nthdimtech/signet-cad/Plots/signet-schematic.pdf

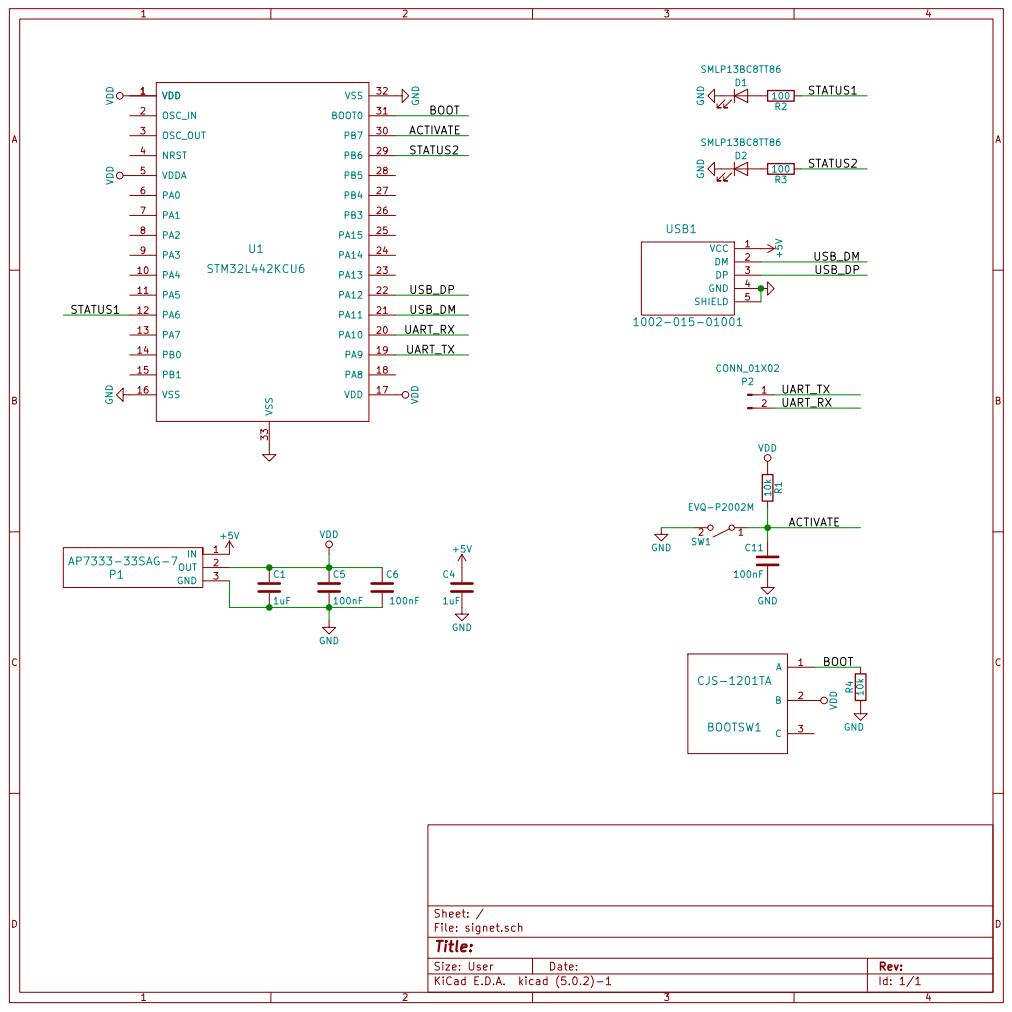
[picture p1: page 1]
