nthdimtech/signet-cad/(threads)

Thread 1 (2017-10-14):

Protection against HW attacks

dumblob, 2017-10-14:
How do you protect the content of the storage (i.e. flash memory) against HW attacks?

Mainly against reading it out e.g. by connecting to appropriate pins on the PCB and messing up with the signals (including clock/crystal). I could not find you're burning some internal transistors to protect against such attacks nor you're allowing the user to lock the flash memory (before any reading or writing can start) by a very long unique key submitted before any use. I'm not sure which locking features the chosen MCU has, but for me this is a very important question.

dumblob, 2017-10-14:
E.g. https://www.cl.cam.ac.uk/~sps32/mcu_lock.html .

nthdimtech, 2017-10-20:
Yes this is something that is on my radar. The STM32L series has memory protection features that

1) Prevent the factory boot-loader from begin activated which could allow hostile firmware to be installed
2) Prevent the SWD debugging interface from being activated which could allow flash to be read/written

See the "flash memory protection" section on page 89 of the MCU reference manual: http://www.st.com/resource/en/reference_manual/dm00151940.pdf

I'm planning on enabling this feature as soon as I support firmware update with digital signature checking. Otherwise the firmware update mechanism in the application (not the factory code) is a trivial workaround to the hardware memory protection features.

I'm using an internally generated clock so the only other kind of attack to consider is manipulation of the external voltage levels. The MCU has some protections and alarms for this kind of thing but I haven't investigated them deeply yet. I'll fine some bugs for this.

dragon788, 2017-10-20:
This probably won't affect the Signet unless it gets smartcard capabilities, but in the vein of security see also the awesome ROCA vulnerability. https://crocs-muni.github.io/roca/

Thread 2 (2017-10-20):

Firmware upload with digital signature checking

nthdimtech, 2017-10-20:
During device initialization the user should be allowed to set a "security level". For any value other than the lowest security level firmware updates will have to have a correct digital signature. In a medium security level setting the signing key would bet set at initialization but could be changed later. At a high security level the signing key would be fixed for the lifetime of the device after initialization.

nthdimtech, 2017-10-21:
This issue belongs in the firmware repository. Moving...

Closed 2017-10-21.

Thread 3 (2017-11-11):

Protection against environmental conditions

dumblob, 2017-11-11:
I wonder whether I can put Signet into a salty water, leave it there for two weeks, put it out, let it dry (at least a bit) and connect to a computer. It sounds pretty extreme, but it's a time-condensed test for e.g. United Arabic Emirates (yeah, I'm in that country more and more often and the salty humidity of 95% is really an electronics killer).

Is there any water-resistant coating on the PCB and possibly some finish of the PCB with already all components mounted?

nthdimtech, 2017-11-11:
I am not planning on putting any special finishes on the pcb but it's worthy of some experiments. The button on the pcb would likely still be a point of failure because it's not a sealed component.

What I've found is that Signet is pretty resilient to short circuits as I have accidentally made a number of them during various tests. In every case Signet would fail to start and then would come up fine after the short was fixed.

What I would do is use Signet as normal, unmodified, and clean it now and then with a stiff brush and isopropyl acholhol. I can't make any promises but I think you'd stand a decent chance of keeping the device alive. If you do this let me know your experience.

Thanks,
Neils

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

--
Sent from my Android device with K-9 Mail. Please excuse my brevity.
