nthdimtech/signet-cad/(commit log)

2017-09-03 Adding DIP switch on back of board for boot mode selection
    [signet.sch]
2017-09-07 Add missing PCB file
    [signet-l442-pcb.kicad_pcb]
2017-10-08 Add 4.7uF capacitor as per STM32 hardware design recommendations
    Board has been mostly stable with only a 1uF cap recommended by the
    regulator's datasheet but there have been some glitches that could
    be hardware related so I'm playing it safe.
    [signet-l442-pcb.kicad_pcb, signet.sch]
2017-10-10 Improve silkscreen
    - Add product name and revision
    - Move references so they can be easily seen
    [signet-l442-pcb.kicad_pcb, signet.sch]
2017-11-01 Adjust pads for activation switch and add shell/ground connections
2017-11-01 Add TVS diodes for ESD protection
    [signet-l442-pcb.kicad_pcb, signet.sch]
2017-11-01 Shield the ground connection
    [signet-l442-pcb.kicad_pcb, signet.sch]
2017-11-09 Make room for 805 caps in power supply and drop ESD chip
    Power supply stability seems to be the real cause of instability, not over
    voltage or ESD and larger caps are needed to stabilize the power supply.
    [signet-l442-pcb.kicad_pcb, signet.sch]
2017-11-10 Add ground ring and an 100nF cap at the regulator input
    [signet-l442-pcb.kicad_pcb, signet.sch]
2017-11-23 Changes for v1.02
    - return to known working configuration of 1uf regulator capacitors
    - Use lower actuation force tactile switch
    - 0603 package instead of 0402 for regulator capacitors
    - 100nf instead of 10nf for activation button capacitor
    - Smaller text on footprint labels
    [signet-l442-pcb.kicad_pcb, signet.sch]
2017-11-29 Move boot switch pulldown out of the way of boot switch
    [signet-l442-pcb.kicad_pcb]
2017-12-30 New tactile switch: KMR211GLFS
2017-12-30 Rev 1.1
    - New tactile switch KMR221GLFS
    - Move LED's closer to center since the new switch gives room
    - Use only 2 VIA's from ground plane to MCU ground pads
    [signet-l442-pcb.kicad_pcb, signet.sch]
2018-02-01 Rev 1.2
    - Test points for UART/GPIO access
    - EVQ-P2002M switch
    - Removed VDDA cap
    [signet-l442-pcb.kicad_pcb, signet.sch]
2018-03-28 Shrinking VIA drill holes to increase copper ring width
    [signet-l442-pcb.kicad_pcb]
2019-04-16 Tidy up
    - Make schematic more readable. Hide footprint text and improve visual
    layout.
    - Remove rev 1 PCB files. The function of rev 1 is identical but with a
    different tactile switch. It has no schematic so keeping the PCB files
    around is probably not helpful
    - Remove some unused files created during prototyping
    [12Mhz_oscillator.sch, mmc_receptical.sch, signet-l442-pcb.kicad_pcb, signet-pcb.kicad_pcb, signet.sch]
2019-04-16 Commit PCB and schematic plots
    These files are generated but it's useful to provide them for people
    to understand the circuit without having to install KiCad.
    [signet-pcb-B.Cu.gbl, signet-pcb-B.Mask.gbs, signet-pcb-B.Paste.gbp, signet-pcb-B.SilkS.gbo, signet-pcb-Edge.Cuts.gm1, signet-pcb-F.Cu.gtl, signet-pcb-F.Mask.gts, signet-pcb-F.Paste.gtp]
